anung-git/skripsi/SOFTWARE/Android/gambar/motor_pump.jpg

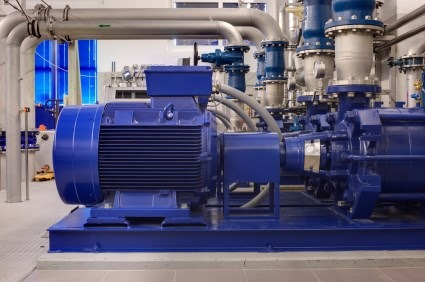
SOFTWARE/Android/gambar/motor_pump.jpg
