anung-git/skripsi/PPT/Skripsi Anung.pptx

Kendali Pompa Air Berbasis IoT

Oleh:
Anung
312118052

## Slide 2

Latar
Belakang

Easy to change colors.

Get a modern PowerPoint Presentation that is beautifully designed. Easy to change colors, photos and Text. You can simply impress your audience and add a unique zing and appeal to your Presentations. Get a modern PowerPoint Presentation that is beautifully designed. Easy to change colors, photos and Text.
You can simply impress your audience and add a unique zing and appeal to your Presentations. You can simply impress your audience and add a unique zing and appeal to your Presentations. Get a modern PowerPoint Presentation that is beautifully designed. Easy to change colors, photos and Text. You can simply impress your audience and add a unique zing and appeal to your Presentations. Get a modern PowerPoint Presentation that is beautifully designed. Easy to change colors, photos and Text.
You can simply impress your audience and add a unique zing and appeal to your Presentations.

## Slide 3

Section Break

Insert the Sub Title of Your Presentation

## Slide 4

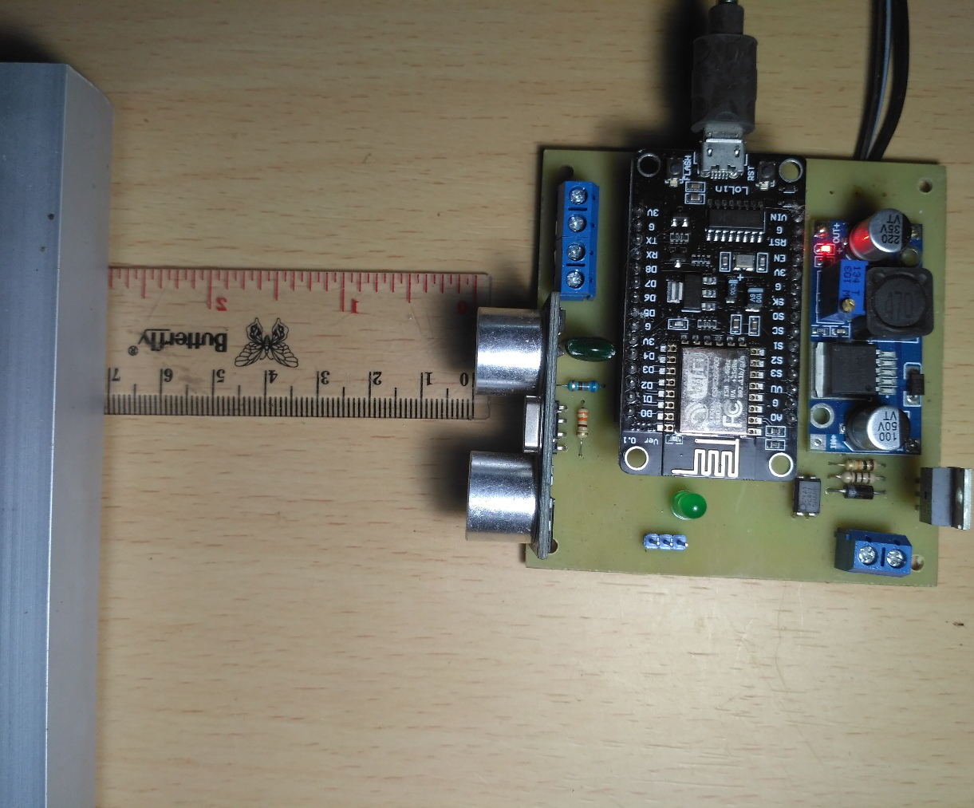
[picture p2: figure]

Pengujian
Sensor PING

Easy to change colors, photos and Text.

Get a modern PowerPoint Presentation that is beautifully designed. Easy to change colors, photos and Text. You can simply impress your audience and add a unique zing and appeal to your Presentations. Get a modern PowerPoint Presentation that is beautifully designed. Easy to change colors, photos and Text. Get a modern PowerPoint Presentation that is beautifully designed. You can simply impress your audience and add a unique zing and appeal to your Presentations.

Get a modern PowerPoint Presentation that is beautifully designed.

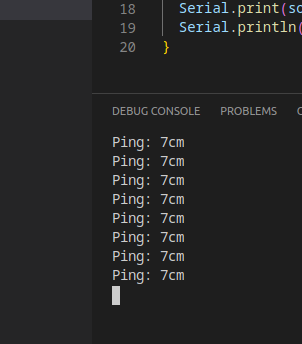
[picture p3: figure]

You can simply impress your audience and add a unique zing and appeal.

## Slide 5

Agenda Style

Contents Title

You can simply impress your audience and add a unique zing and appeal to your Presentations. Easy to change colors, photos and Text.

Contents Title

You can simply impress your audience and add a unique zing and appeal to your Presentations. Easy to change colors, photos and Text.

Contents Title

You can simply impress your audience and add a unique zing and appeal to your Presentations. Easy to change colors, photos and Text.

Contents Title

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

01

02

03

04

## Slide 6

AWESOME

PRESENTATION

EASY TO CHANGE COLORS, PHOTOS.

You can simply impress your audience and add a unique zing and appeal to your Presentations. Get a modern PowerPoint Presentation that is beautifully designed. I hope and I believe that this Template will your Time, Money and Reputation.

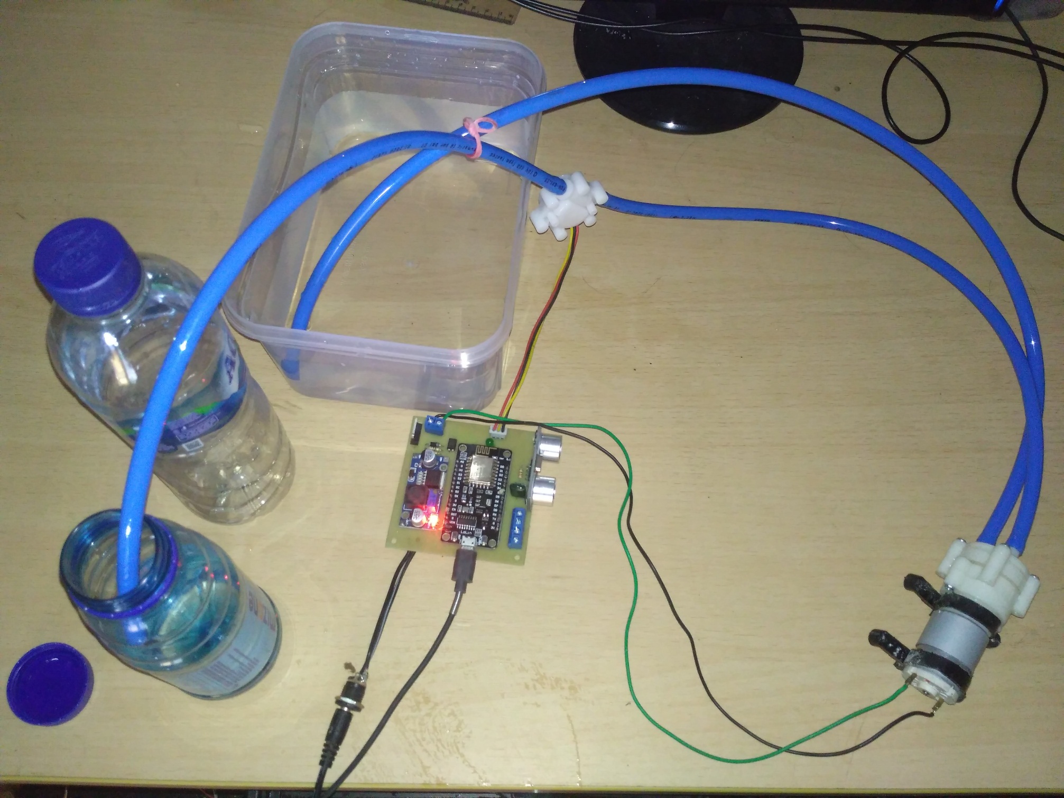
[picture p4: figure]

Get a modern PowerPoint Presentation that is beautifully designed.

I hope and I believe that this Template will your Time, Money and Reputation. Easy to change colors, photos and Text. You can simply impress your audience and add a unique zing and appeal to your Presentations

MODERN

PowerPoint

DESIGN

## Slide 7

AWESOME

PRESENTATION

EASY TO CHANGE COLORS, PHOTOS.

You can simply impress your audience and add a unique zing and appeal to your Presentations. Get a modern PowerPoint Presentation that is beautifully designed. I hope and I believe that this Template will your Time, Money and Reputation.

Get a modern PowerPoint Presentation that is beautifully designed.

I hope and I believe that this Template will your Time, Money and Reputation. Easy to change colors, photos and Text. You can simply impress your audience and add a unique zing and appeal to your Presentations

MODERN

PowerPoint

DESIGN

## Slide 8

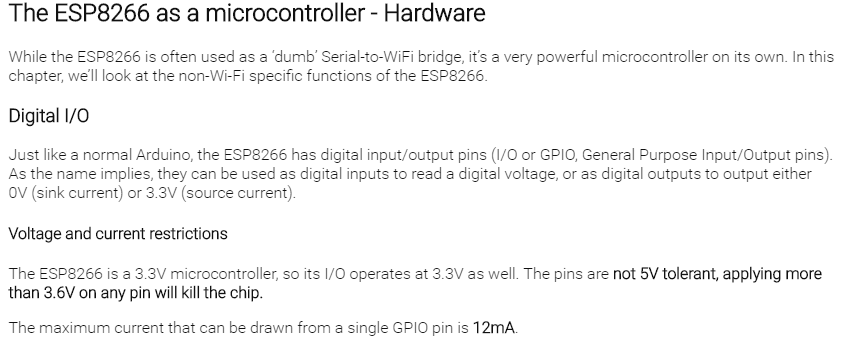
[picture p5: figure]

## Slide 9

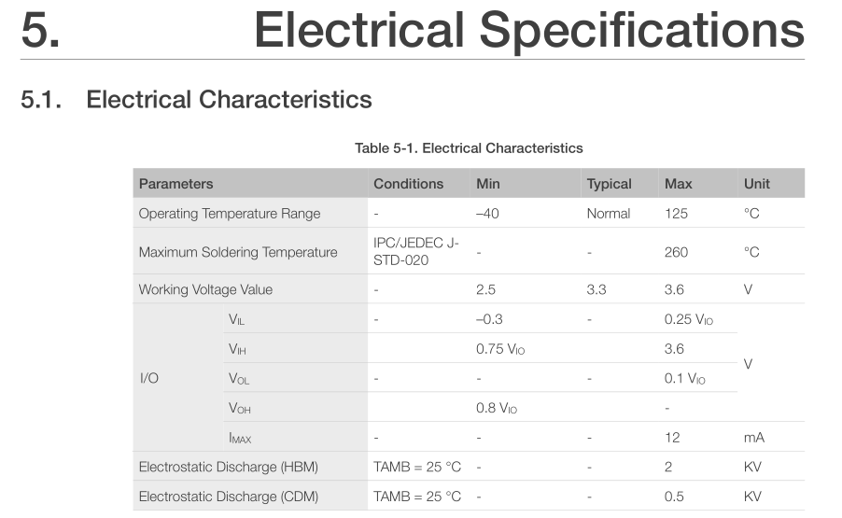
[picture p6: figure]

## Slide 10

- Timeline Infographic

2013

2014

2015

2016

2017

2018

2019

Content Here

Get a modern PowerPoint Presentation that is beautifully designed

Content Here

Get a modern PowerPoint Presentation that is beautifully designed

Content Here

Get a modern PowerPoint Presentation that is beautifully designed

Content Here

Get a modern PowerPoint Presentation that is beautifully designed

Content Here

Get a modern PowerPoint Presentation that is beautifully designed

Content Here

Get a modern PowerPoint Presentation that is beautifully designed

Content Here

Get a modern PowerPoint Presentation that is beautifully designed

## Slide 11

- Our Team Infographic

We Create
Professional Presentation

Get a modern PowerPoint Presentation that is beautifully designed. I hope and I believe that this Template will your Time, Money and Reputation. Easy to change colors, photos and Text. Get a modern PowerPoint Presentation that is beautifully designed. You can simply impress your audience and add a unique zing and appeal to your Presentations.

Work Experience

2013 ~ 2014 Text here
Example Text : Get a modern PowerPoint Presentation that is beautifully designed.

2014 ~ 2016Text here
Example Text : Get a modern PowerPoint Presentation that is beautifully designed

2016 ~ 2019 Text here
Example Text : Get a modern PowerPoint Presentation that is beautifully designed.

Progress Company

Presentation

Presentation

Presentation

Presentation

MICHAEL DOE

## Slide 12

- Infographic Style

Modern PowerPoint Presentation

NO.1 Presentation

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

Contents Title

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

Contents Title

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

Contents Title

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

## Slide 13

- Infographic Style

Your Text Here

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

STRENGTHS

OPPORTUNITIES

WEAKNESS

THREATS

S

W

Your Text Here

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

Your Text Here

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

O

T

Your Text Here

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

## Slide 14

AWESOME
SLIDE

LOREM IPSUM DOLOR SIT AMET,
CU USU AGAM INTEGRE IMPEDIT.

Your Text Here

Your Text Here

Your Text Here

Easy to change colors, photos and Text.

$ 64,090

LOREM IPSUM DOLOR SIT AMET,
CU USU AGAM INTEGRE IMPEDIT.

Easy to change colors, photos and Text.

$124,090

LOREM IPSUM DOLOR SIT AMET,
CU USU AGAM INTEGRE IMPEDIT.

Easy to change colors, photos and Text.

$234,090

## Slide 15

- MQTT Basic

INSERT CONTENTS

INSERT CONTENTS

Publish

MQTT
Broker

Subscibe

INSERT CONTENTS

INSERT CONTENTS

You can simply impress your audience and add a unique zing and appeal to your Reports and Presentations with our Templates. Get a modern PowerPoint Presentation that is beautifully designed.

## Slide 16

- Infographic Style

Your Text Here

You can simply impress your audience and add a unique zing and appeal to your Presentations.

Your Text Here

You can simply impress your audience and add a unique zing and appeal to your Presentations.

Your Text Here

You can simply impress your audience and add a unique zing and appeal to your Presentations.

## Slide 17

Industrial Automation Solutions

POWERPOINT

You can simply impress your audience and add a unique zing and appeal to your Presentations

CONTENTS

You can simply impress your audience and add a unique zing and appeal to your Presentations.

You can simply impress your audience and add a unique zing and appeal to your Presentations.

TEXT

## Slide 18

- Infographic Style

Industrial automation

Your Text Here

You can simply impress your audience and add a unique zing and appeal to your Presentations.

Your Text Here

You can simply impress your audience and add a unique zing and appeal to your Presentations.

Your Text Here

You can simply impress your audience and add a unique zing and appeal to your Presentations.

Your Text Here

You can simply impress your audience and add a unique zing and appeal to your Presentations.

Your Text Here

You can simply impress your audience and add a unique zing and appeal to your Presentations.

Your Text Here

You can simply impress your audience and add a unique zing and appeal to your Presentations.

## Slide 19

- Infographic Style

1st

Your Text Here

I hope and I believe that this Template will your Time, Money and Reputation. Get a modern PowerPoint Presentation that is beautifully designed.

3st

Your Text Here

I hope and I believe that this Template will your Time, Money and Reputation. Get a modern PowerPoint Presentation that is beautifully designed.

2st

Your Text Here

I hope and I believe that this Template will your Time, Money and Reputation. Get a modern PowerPoint Presentation that is beautifully designed.

4st

Your Text Here

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

## Slide 20

- Infographic Style

Your Text Here

You can simply impress your audience and add a unique zing and appeal to your Presentations.

Your Text Here

You can simply impress your audience and add a unique zing and appeal to your Presentations.

Text Here

Your Text Here

You can simply impress your audience and add a unique zing and appeal to your Presentations.

Your Text Here

You can simply impress your audience and add a unique zing and appeal to your Presentations.

## Slide 21

- Infographic Style

Contents Title

You can simply impress your audience and add a unique zing and appeal to your Presentations.

Contents Title

You can simply impress your audience and add a unique zing and appeal to your Presentations.

Contents Title

You can simply impress your audience and add a unique zing and appeal to your Presentations.

## Slide 22

Portfolio Designed

You can simply impress your audience and add a unique zing and appeal to your Presentations. I hope and I believe that this Template will your Time, Money and Reputation. Get a modern PowerPoint Presentation that is beautifully designed. You can simply impress your audience and add a unique zing and appeal to your Presentations.
Get a modern PowerPoint Presentation that is beautifully designed.

Content Here

Get a modern PowerPoint Presentation that is beautifully designed. Easy to change colors, photos and Text.

Content Here

Get a modern PowerPoint Presentation that is beautifully designed. Easy to change colors, photos and Text.

Portfolio Presentation

INDUSTRY

Content Here

Get a modern PowerPoint Presentation that is beautifully designed. Easy to change colors, photos and Text.

Content Here

Get a modern PowerPoint Presentation that is beautifully designed. Easy to change colors, photos and Text.

## Slide 23

Simple PowerPoint Presentation

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

Contents _ Graph

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

Contents

Contents

Contents

Contents _ Graph

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

Contents _ Graph

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

## Slide 24

- Infographic Style

02

03

01

04

03

01

Content Here

You can simply impress your audience and add a unique zing and appeal to your Presentations.

80%

60%

02

50%

Content Here

You can simply impress your audience and add a unique zing and appeal to your Presentations.

40%

Content Here

You can simply impress your audience and add a unique zing and appeal to your Presentations.

04

Content Here

You can simply impress your audience and add a unique zing and appeal to your Presentations.

## Slide 25

ALLPPT Layout
Clean Text Slide for your Presentation

Get a modern PowerPoint Presentation that is beautifully designed. Easy to change colors, photos and Text. You can simply impress your audience and add a unique zing and appeal to your Presentations. Get a modern PowerPoint Presentation that is beautifully designed. Easy to change colors, photos and Text.
Easy to change colors, photos and Text. You can simply impress your audience and add a unique zing and appeal to your Presentations.

Add Contents Title

## Slide 26

- Infographic Style

Content Here

Get a modern PowerPoint Presentation that is beautifully designed. hope and I believe that this Template will your Time.

Content Here

Get a modern PowerPoint Presentation that is beautifully designed. hope and I believe that this Template will your Time.

Content Here

Get a modern PowerPoint Presentation that is beautifully designed. hope and I believe that this Template will your Time.

Content Here

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

## Slide 27

- Infographic Style

TITLE | A TITLE | | | B TITLE | | | C TITLE
Replaced with your own text. | Text Here | | | Text | | | Content Here
PowerPiont Template | Content Here | | | Content Here | | | Text
Replaced with your own text. | Text Here | | | Text | | | Content Here
PowerPiont Template | Content Here | | | Content Here | | | Text
Replaced with your own text. | Text Here | | | Text | | | Content Here
PowerPiont Template | Content Here | | | Content Here | | | Text
Replaced with your own text. | Text Here | | | Text | | | Content Here
PowerPiont Template | Content Here | | | Content Here | | | Text
Content Here | Text Here | | | Text | | | Content Here
| | Content Here | | | Content Here | | | Content Here

## Slide 28

Awesome Presentation

We Create Professional Presentation

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

## Slide 29

- Infographic Style

Add Contents Title

You can simply impress your audience and add a unique zing and appeal to your Presentations.

Add Contents Title

You can simply impress your audience and add a unique zing and appeal to your Presentations.

Add Contents Title

You can simply impress your audience and add a unique zing and appeal to your Presentations.

Add Contents Title

You can simply impress your audience and add a unique zing and appeal to your Presentations.

Add Contents Title

You can simply impress your audience and add a unique zing and appeal to your Presentations.

## Slide 30

- Infographic Style

| You can simply impress your audience and add a unique zing
| Add Text

| You can simply impress your audience and add a unique zing
| Add Text

Your Text Here

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

| You can simply impress your audience and add a unique zing
| Add Text

Your Text Here

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

| You can simply impress your audience and add a unique zing
| Add Text

Add Text

Easy to change colors, photos and Text.

## Slide 31

Get a modern PowerPoint Presentation that is beautifully designed.

Get a modern PowerPoint Presentation that is beautifully designed.

Get a modern PowerPoint Presentation that is beautifully designed.

Get a modern PowerPoint Presentation that is beautifully designed.

Get a modern PowerPoint Presentation that is beautifully designed.

Get a modern PowerPoint Presentation that is beautifully designed.

Get a modern PowerPoint Presentation that is beautifully designed.

## Slide 32

- Infographic Style

CLOUD COMPUTING

Content Here

Get a modern PowerPoint Presentation that is beautifully designed.

Content Here

Get a modern PowerPoint Presentation that is beautifully designed.

Content Here

Get a modern PowerPoint Presentation that is beautifully designed.

## Slide 33

- Infographic Style

Your Text Here | | | Your Text Here | | | Your Text Here | | | Your Text Here
| Text Here | | | Text Here | | | Text Here | | | Text Here
| Text Here | | | Text Here | | | Text Here | | | Text Here
| Text Here | | | Text Here | | | Text Here | | | Text Here
| Text Here | | | Text Here | | | Text Here | | | Text Here
| Text Here | | | Text Here | | | Text Here | | | Text Here
| Text Here | | | Text Here | | | Text Here | | | Text Here
| $ 1200 | | | $1000 | | | $600 | | | $500

## Slide 34

- Infographic Style

Get a modern PowerPoint Presentation that is beautifully designed.

Get a modern PowerPoint Presentation that is beautifully designed.

Get a modern PowerPoint Presentation that is beautifully designed.

Get a modern PowerPoint Presentation that is beautifully designed.

Content Here

Content Here

Content Here

Content Here

## Slide 35

- Infographic Style

Add Text

Easy to change colors, photos and Text.

Add Contents

Add Text

Easy to change colors, photos and Text.

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

Add Text

Easy to change colors, photos and Text.

Add Contents

Add Text

Easy to change colors, photos and Text.

Add Contents

Add Contents

## Slide 36

- Infographic Style

01

02

03

04

Content Here

Get a modern PowerPoint Presentation that is beautifully designed. I hope and I believe that this Template will your Time.
You can simply impress your audience and add a unique zing and appeal to your Reports.

Content Here

Get a modern PowerPoint Presentation that is beautifully designed. I hope and I believe that this Template will your Time.
You can simply impress your audience and add a unique zing and appeal to your Reports.

Content Here

Get a modern PowerPoint Presentation that is beautifully designed. I hope and I believe that this Template will your Time.
You can simply impress your audience and add a unique zing and appeal to your Reports.

Content Here

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

## Slide 37

Get a modern PowerPoint

You can simply impress your audience and add a unique zing and appeal to your Presentations. Easy to change colors, photos and Text. Get a modern PowerPoint Presentation that is beautifully designed. You can simply impress your audience and add a unique zing and appeal to your Presentations.

Simple Portfolio Presentation

Content Here : I hope and I believe that this Template will your Time.

Content Here : I hope and I believe that this Template will your Time.

Content Here : I hope and I believe that this Template will your Time.

Content Here : I hope and I believe that this Template will your Time.

Content Here : I hope and I believe that this Template will your Time.

## Slide 38

- Infographic Style

65%

75%

$23,900

Contents Here

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

$23,900

Contents Here

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

## Slide 39

- Infographic Style

Content Here

Get a modern PowerPoint Presentation that is beautifully designed.

Content Here

Get a modern PowerPoint Presentation that is beautifully designed.

Content Here

Get a modern PowerPoint Presentation that is beautifully designed.

Content Here

Get a modern PowerPoint Presentation that is beautifully designed.

Content Here

Get a modern PowerPoint Presentation that is beautifully designed.

Content Here

Get a modern PowerPoint Presentation that is beautifully designed.

Content Here

Get a modern PowerPoint Presentation that is beautifully designed.

## Slide 40

Simple
Portfolio Presentation

Easy to change colors, photos and Text.

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

Get a modern PowerPoint Presentation that is beautifully designed.

You can simply impress your audience and add a unique zing and appeal.

## Slide 41

- Infographic Style

Country

Data_01 : 12,000
Data_02 : 23,300

Country

Data_01 : 12,000
Data_02 : 23,300

Country

Data_01 : 12,000
Data_02 : 23,300

Country

Data_01 : 12,000
Data_02 : 23,300

Contents
Performance

Easy to change colors, photos and Text.

Contents
Performance

Easy to change colors, photos and Text.

Contents
Performance

Easy to change colors, photos and Text.

Contents
Performance

Easy to change colors, photos and Text.

## Slide 42

- Infographic Style

Text Here Modern PowerPoint
$25
Contents | | Text
| Text Here
| Content Here
| Text Here
| Text Here
| Easy to change colors, photos and Text.

Text Here Modern PowerPoint
$100
Contents | | Text
| Text Here
| Content Here
| Text Here
| Text Here
| Easy to change colors, photos and Text.

Text Here Modern PowerPoint
$65
Contents | | Text
| Text Here
| Content Here
| Text Here
| Text Here
| Easy to change colors, photos and Text.

Text Here Modern PowerPoint
$20
Contents | | Text
| Text Here
| Content Here
| Text Here
| Text Here
| Easy to change colors, photos and Text.

## Slide 43

Portfolio Designed

You can simply impress your audience and add a unique zing and appeal to your Presentations. I hope and I believe that this Template will your Time, Money and Reputation. Get a modern PowerPoint Presentation that is beautifully designed.
Get a modern PowerPoint Presentation that is beautifully designed.

Content

Content

Content

Content

Content Here

Get a modern PowerPoint Presentation that is beautifully designed. Easy to change colors, photos and Text.

Content Here

Get a modern PowerPoint Presentation that is beautifully designed. Easy to change colors, photos and Text.

Simple Portfolio
Presentation

Content Here

Get a modern PowerPoint Presentation that is beautifully designed. Easy to change colors, photos and Text.

Content Here

Get a modern PowerPoint Presentation that is beautifully designed. Easy to change colors, photos and Text.

## Slide 44

- Infographic Style

50%

40%

Your Text Here

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

Your Text Here

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

Content

70%

Your Text Here

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

## Slide 45

- Infographic Style

83%

Your Text Here

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

Your Text Here

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

65%

43%

Your Text Here

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

75%

Your Text Here

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

## Slide 46

Columns Infographic Style

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

## Slide 47

TerimaKasih

## Slide 48

- Fully Editable Shapes

## Slide 49

- Fully Editable Shapes

## Slide 50

- Fully Editable Icon Sets: A

## Slide 51

- Fully Editable Icon Sets: B

## Slide 52

- Fully Editable Icon Sets: C

## Slide 53

- Hall Effect

## Slide 54

## Slide 55

- Hall Efek

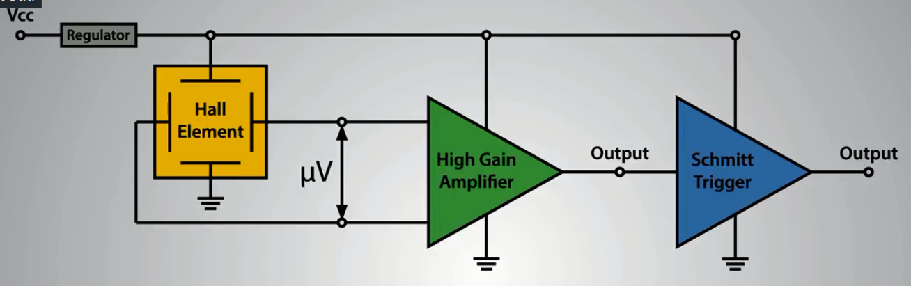
[picture p7: figure]

## Slide 56

- Hall effect

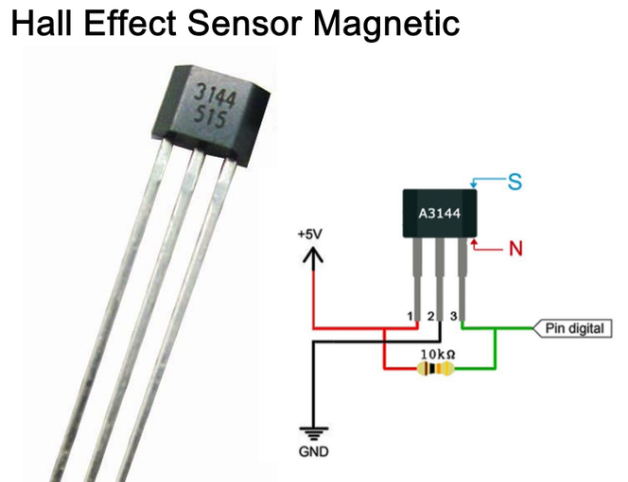
[picture p8: figure]

## Slide 57
