anung-git/skripsi/LAPORAN/flowchart/flow sumur lengkap (6).png

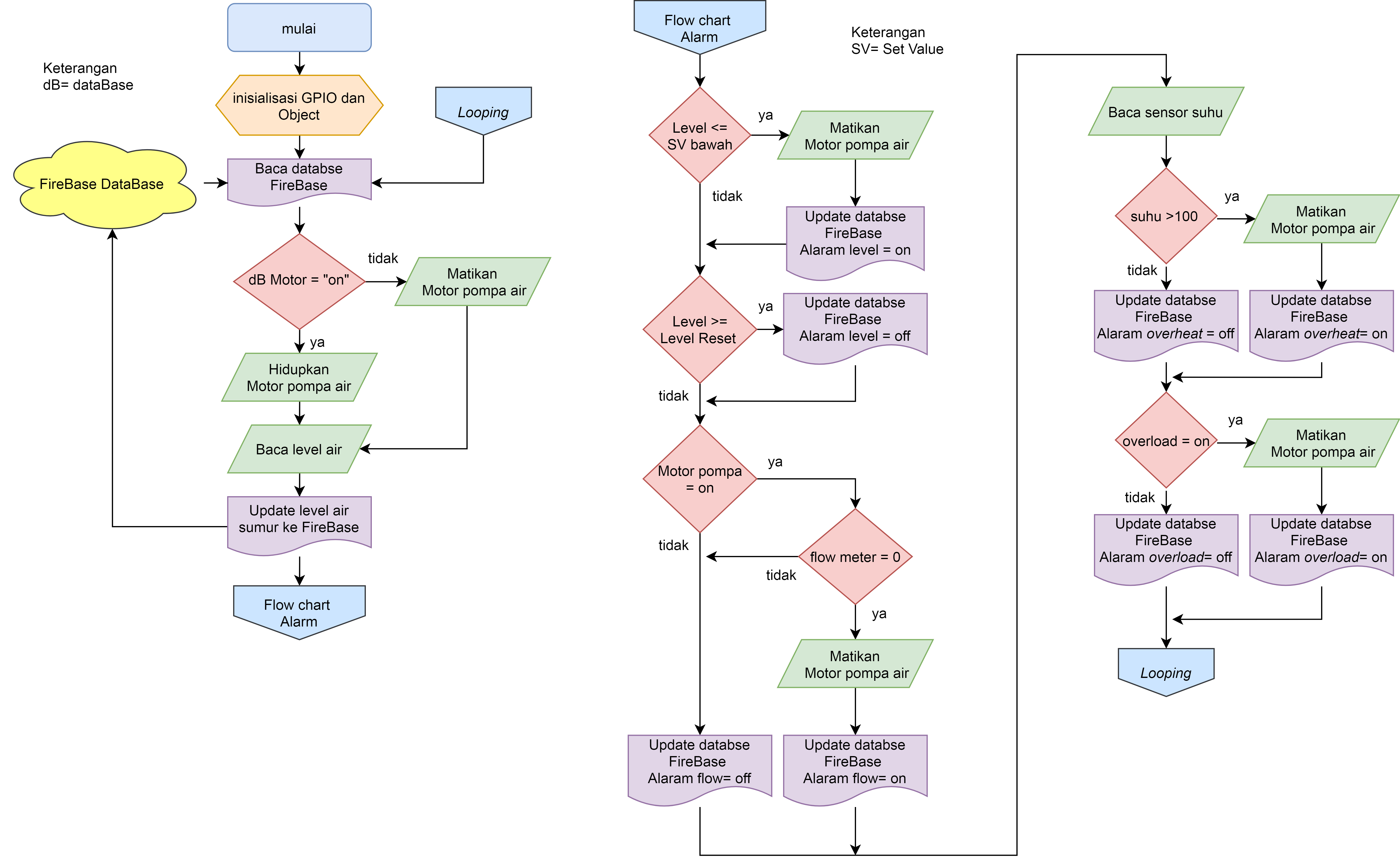
LAPORAN/flowchart/flow sumur lengkap (6).png
