anung-git/skripsi/LAPORAN/flowchart/flow tangki.png

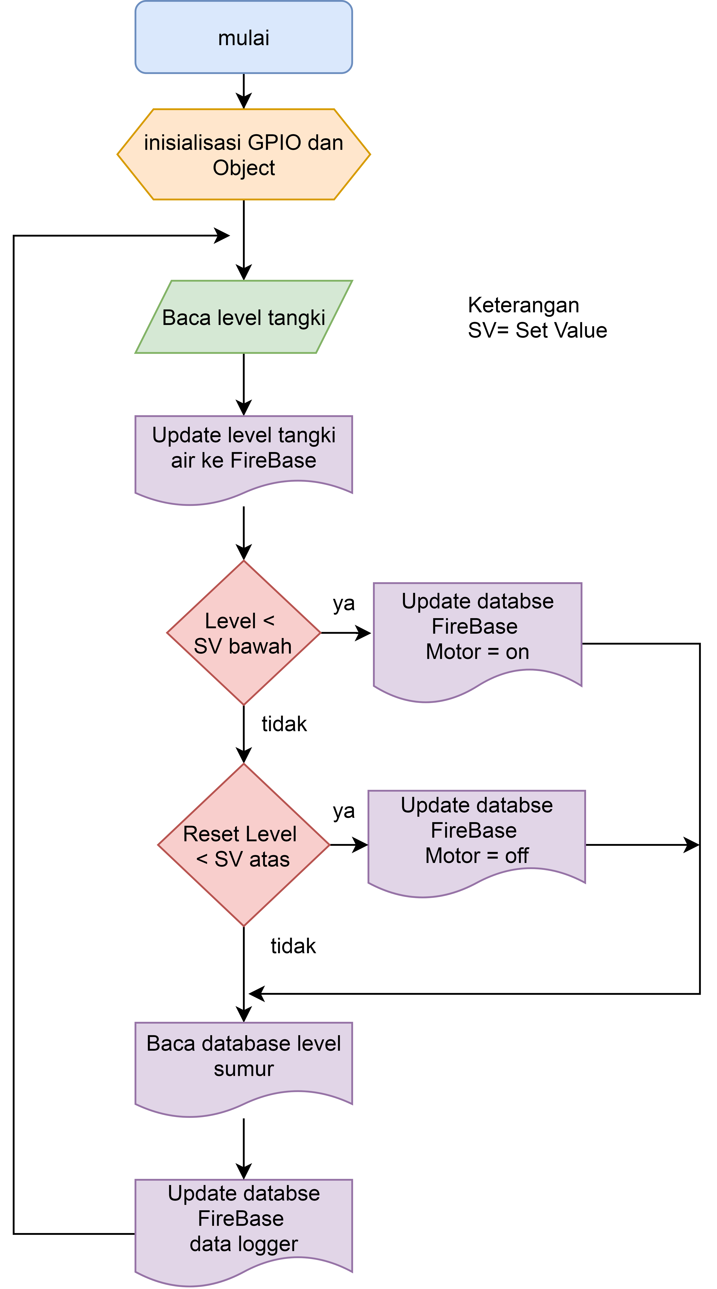
LAPORAN/flowchart/flow tangki.png
