anung-git/skripsi/LAPORAN/skematik/pdf/driver_motor.pdf

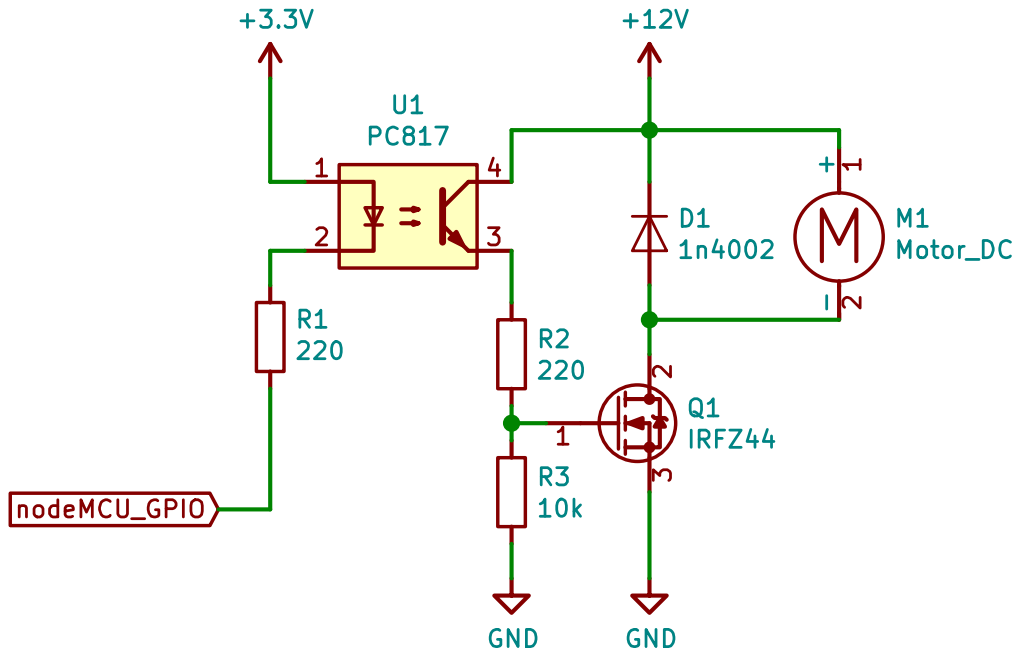
[picture p61: page 1]

File: driver_motor.sch Sheet: / Anung

Id: 1/1 Title: Driver Motor DC
