anung-git/skripsi/LAPORAN/skematik/pdf/sensor_flow.pdf

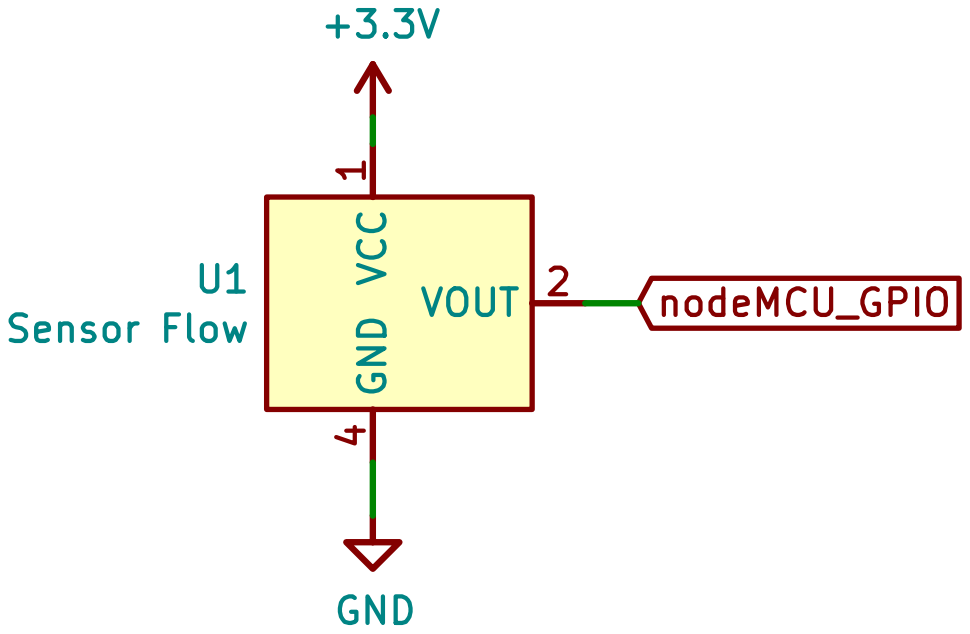
[picture p62: page 1]

1 VOUT 2 GND
File: sensor_flow.sch Sheet: / VCC
