anung-git/skripsi/LAPORAN/skematik/pdf/sensor_suhu.pdf

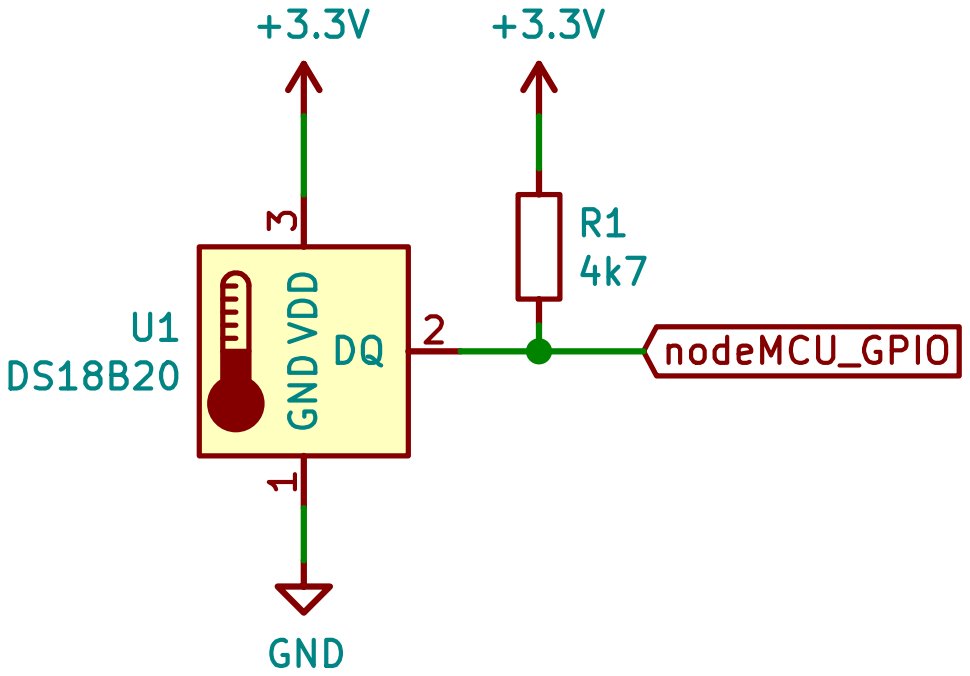
[picture p63: page 1]

1 DQ VDD
File: sensor_ping.sch Sheet: / GND
