anung-git/skripsi/LAPORAN/LAMPIRAN/tangki.pdf

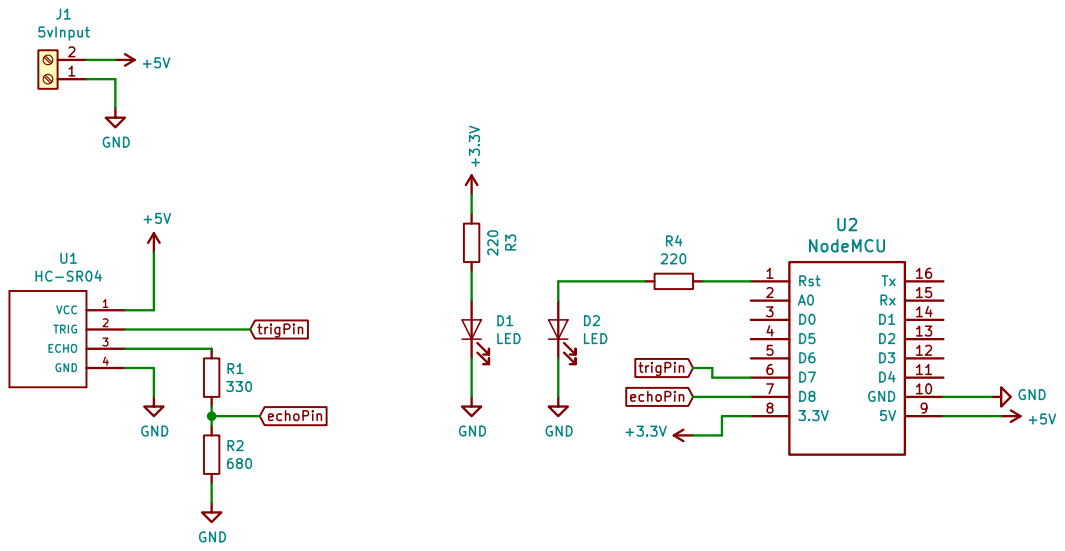
[picture p64: page 1]

File: tangki.sch Sheet: / ANUNG

Id: 1/1 Title: SKRIPSI POMPA AIR IOT
