anung-git/skripsi/LAPORAN/LAMPIRAN/sumur.pdf

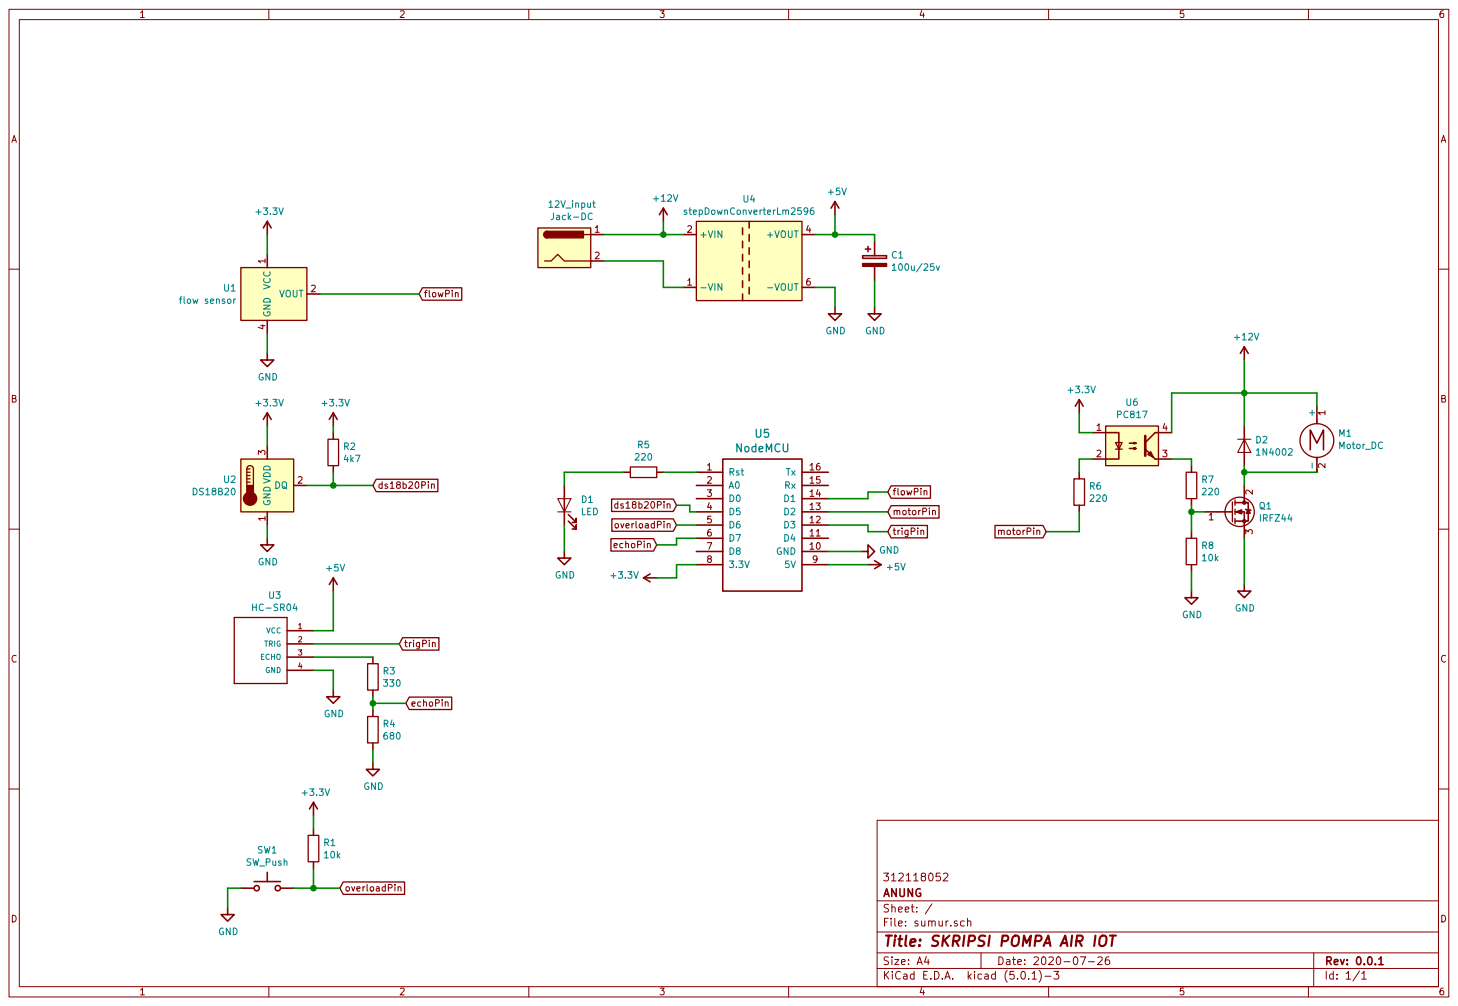
[picture p65: page 1]

File: sumur.sch Sheet: / ANUNG

Id: 1/1 Title: SKRIPSI POMPA AIR IOT
