anung-git/skripsi/LAPORAN/skematik/pdf/pembagi tegangan.pdf

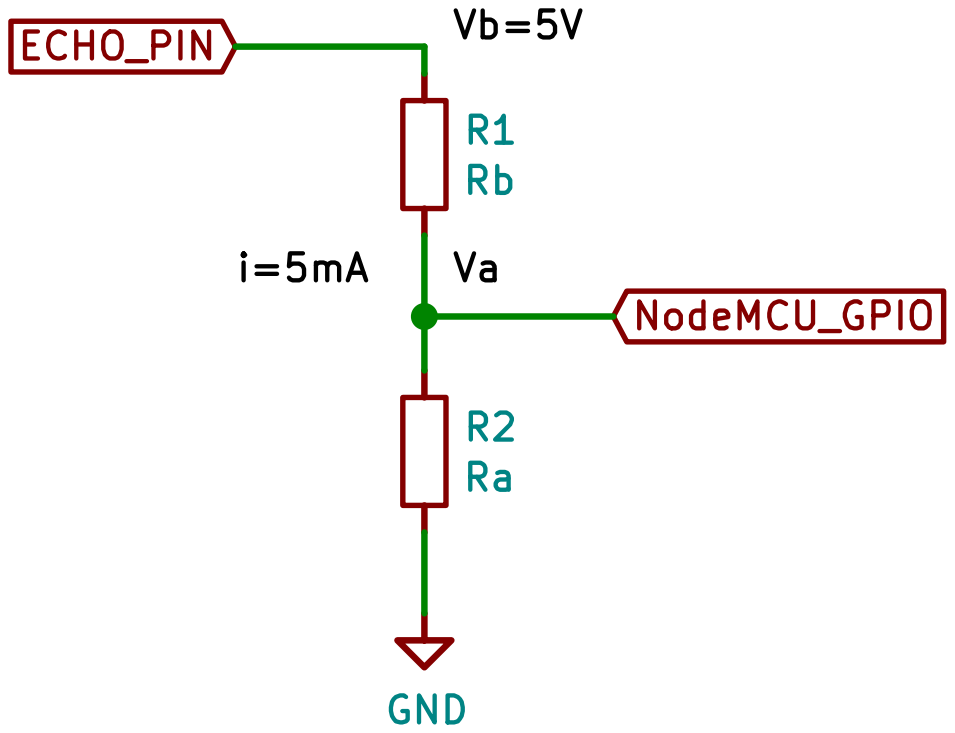
[picture p66: page 1]

File: pembagi tegangan.sch Sheet: /
Id: 1/1 Title:
