anung-git/skripsi/pcb/skripsi/skripsi.kicad_pcb

## KiCad design pcb/skripsi/skripsi.kicad_pcb (2020-08-06)

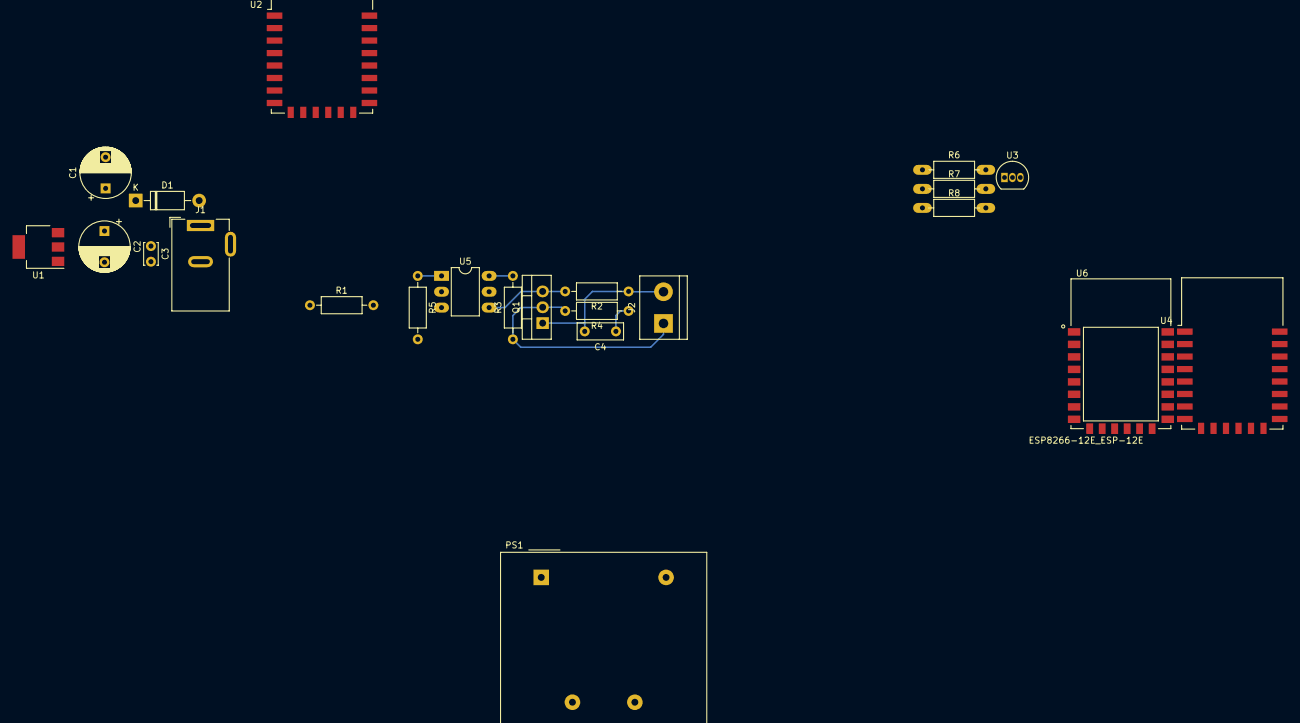
[picture p67: board skripsi.kicad_pcb from above]

Board: 2 copper layers, 23 parts (0 on the bottom side), 14 nets.

Parts:
C1: 470uF/16v; CP_Radial_D8.0mm_P5.00mm
C2: 100uF/16v; CP_Radial_D8.0mm_P5.00mm
C3: 100nF; C_Disc_D3.4mm_W2.1mm_P2.50mm
C4: 10nF/1000v; C_Rect_L7.2mm_W2.5mm_P5.00mm_FKS2_FKP2_MKS2_MKP2
D1: 1n4002; D_DO-41_SOD81_P10.16mm_Horizontal
J1: Jack-DC; BarrelJack_Wuerth_6941xx301002
J2: motor; TerminalBlock_bornier-2_P5.08mm
PS1: HS-40003; Converter_ACDC_Hahn_HS-400xx_THT
Q1: BT136-500; TO-220-3_Vertical
R1, R7, R8: 10k; R_Axial_DIN0207_L6.3mm_D2.5mm_P10.16mm_Horizontal
R2: 330; R_Axial_DIN0207_L6.3mm_D2.5mm_P10.16mm_Horizontal
R3: 360; R_Axial_DIN0207_L6.3mm_D2.5mm_P10.16mm_Horizontal
R4: 39; R_Axial_DIN0207_L6.3mm_D2.5mm_P10.16mm_Horizontal
R5: 68; R_Axial_DIN0207_L6.3mm_D2.5mm_P10.16mm_Horizontal
R6: 4k7; R_Axial_DIN0207_L6.3mm_D2.5mm_P10.16mm_Horizontal
U1: AP1117-33; SOT-223-3_TabPin2
U2: ESP-12E
U3: DS18B20; TO-92_Inline
U4: ESP-12F; ESP-12E
U5: MOC3041M; DIP-6_W7.62mm_LongPads
U6: ESP8266-12E_ESP-12E; XCVR_ESP8266-12E%2fESP-12E

Connections:
+3V3: C2.1, C3.1, R1.1, R6.1, R7.1, U1.2, U2.8, U3.3
+5V: C1.1, D1.1, U1.3
GND: C1.2, C2.2, C3.2, J1.2, R8.2, U1.1, U2.15, U3.1, U5.2
unnamed: C4.1, R4.1
unnamed: C4.2, J2.2, Q1.1, R2.1
unnamed: D1.2, J1.1
unnamed: J2.1, Q1.2, R3.1, R4.2
unnamed: Q1.3, R2.2, U5.4
unnamed: R1.2, U2.1
unnamed: R3.2, U5.6
unnamed: R5.1, U5.1
unnamed: R7.2, U2.18
unnamed: R8.1, U2.16
temp: R6.2, U3.2
