anung-git/skripsi/pcb/KENDALI POMPA TANK.brd

## EAGLE design pcb/KENDALI POMPA TANK.brd (2020-08-06)

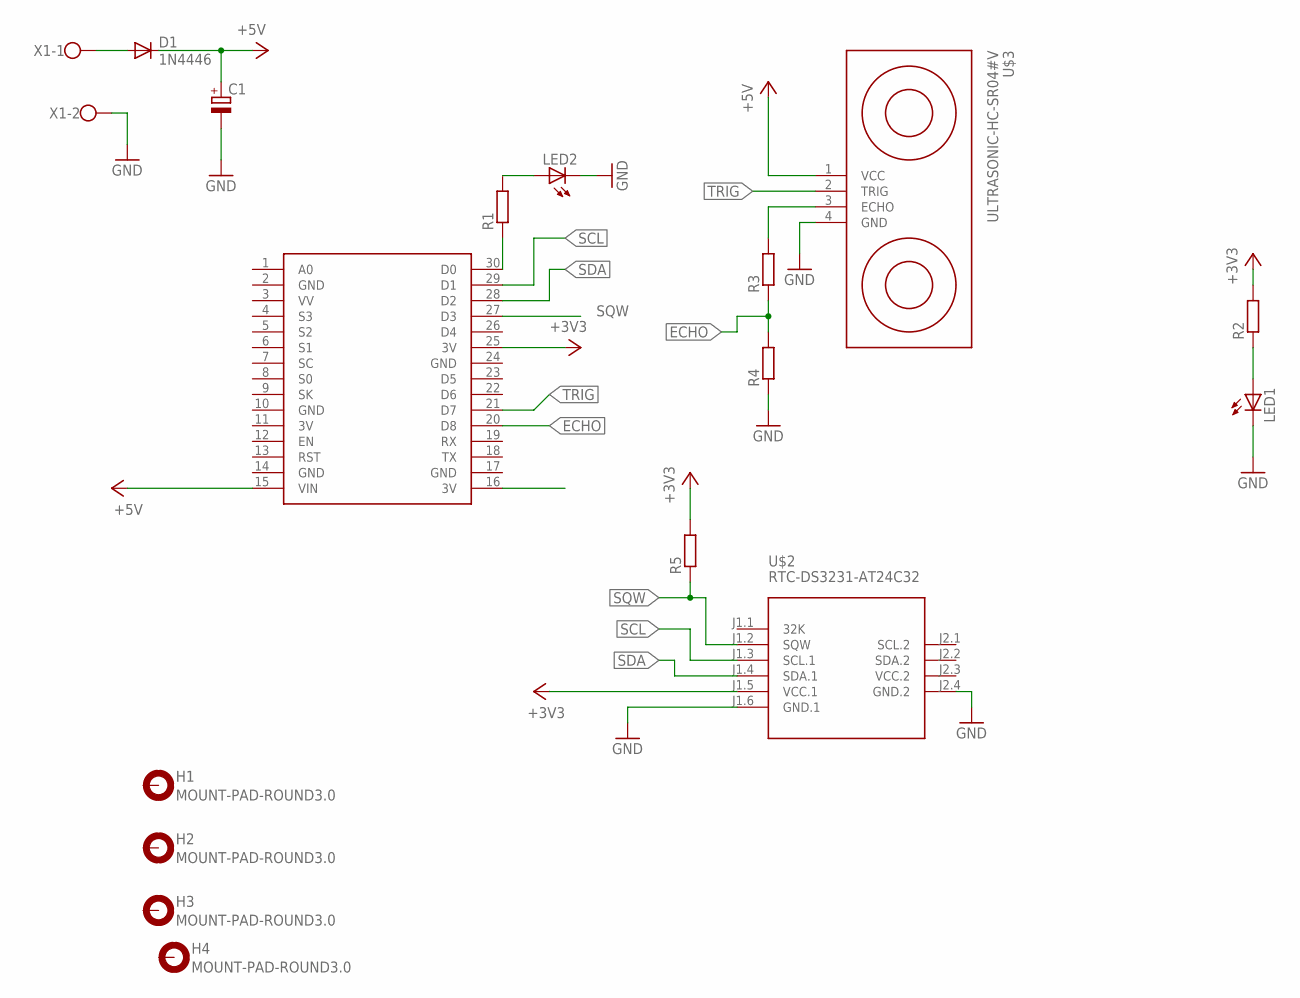
[picture p68: schematic KENDALI POMPA TANK.sch]

Parts:
C1: CPOL-EUE5-5; E5-5
D1: 1N4446; DO35-10
H1, H2, H3, H4: MOUNT-PAD-ROUND3.0; 3,0-PAD
LED1, LED2: LED5MM
R1, R2, R3, R4, R5: R-EU_0207/10; 0207/10
U$1: NODEMCU
U$2: RTC-DS3231-AT24C32
U$3: ULTRASONIC-HC-SR04#V
X1: W237-102

Connections:
3V: U$1.11 (3V)
+3V3: R2.2, R5.2, U$1.25 (3V), U$2.J1.5 (VCC.1)
+5V: C1.+, D1.C, U$1.15 (VIN), U$3.1 (VCC)
ECHO: R3.1, R4.2, U$1.20 (D8)
GND: C1.-, LED1.K (C), LED2.K (C), R4.1, U$1.2 (GND), U$1.10 (GND), U$1.14 (GND), U$1.17 (GND), U$1.24 (GND), U$2.J1.6 (GND.1), U$2.J2.4 (GND.2), U$3.4 (GND), X1.2
unnamed: R1.1, U$1.30 (D0)
unnamed: LED2.A, R1.2
unnamed: LED1.A, R2.1
unnamed: D1.A, X1.1
unnamed: R3.2, U$3.3 (ECHO)
SCL: U$1.29 (D1), U$2.J1.3 (SCL.1)
SDA: U$1.28 (D2), U$2.J1.4 (SDA.1)
SQW: R5.1, U$1.27 (D3), U$2.J1.2 (SQW)
TRIG: U$1.21 (D7), U$3.2 (TRIG)
VCC.2: U$2.J2.3 (VCC.2)

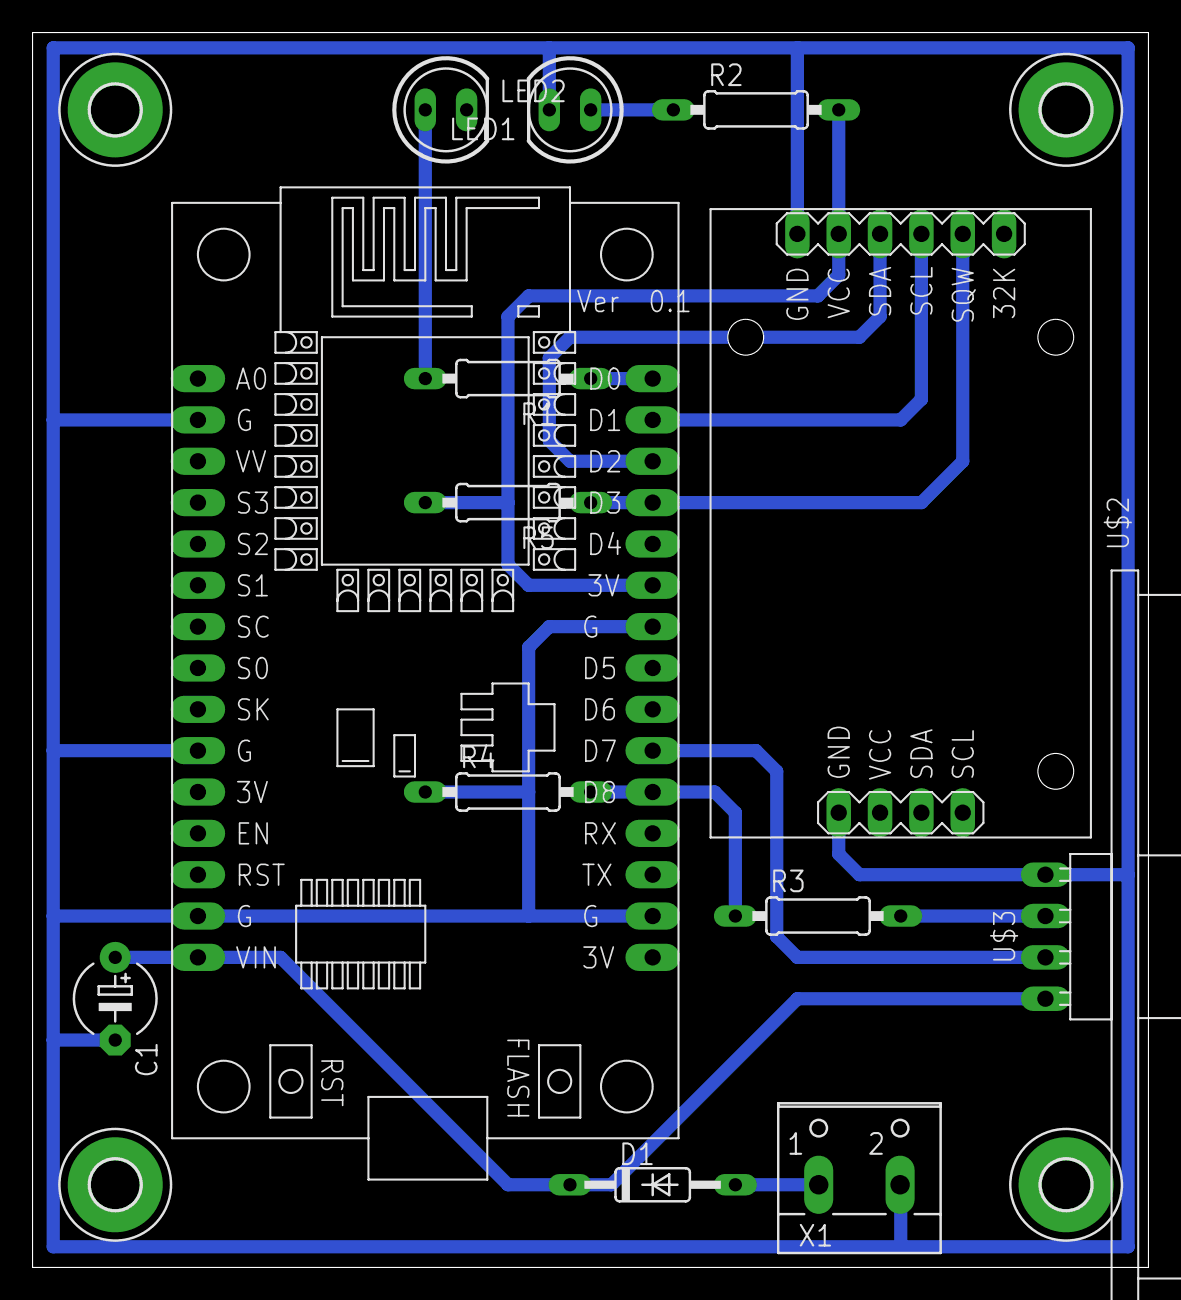
[picture p69: board KENDALI POMPA TANK.brd from above]

Board: 2 copper layers, 68.6 x 75.9 mm, 17 parts (0 on the bottom side), 13 nets.
