anung-git/skripsi/pcb/KENDALI POMPA AIR IOT.brd

## EAGLE design pcb/KENDALI POMPA AIR IOT.brd (2020-08-06)

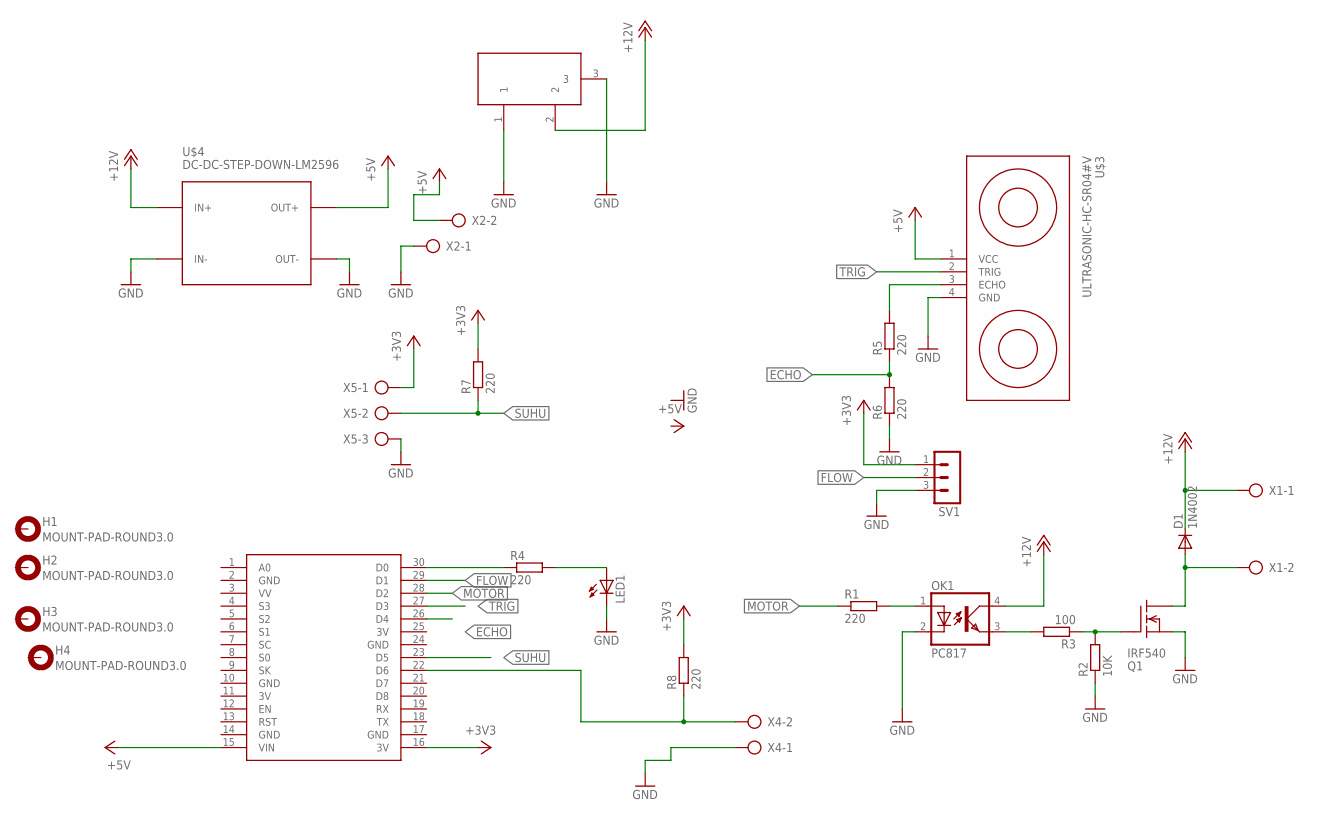
[picture p70: schematic KENDALI POMPA AIR IOT.sch]

Parts:
D1: 1N4002; DO35-10
H1, H2, H3, H4: MOUNT-PAD-ROUND3.0; 3,0-PAD
LED1: LED5MM
OK1: PC817; DIL04
Q1: IRF540; TO220
R1, R4, R5, R6, R7, R8: 220; 0207/10
R2: 10K; 0207/10
R3: 100; 0207/10
SV1: MA03-1
U$1: NODEMCU
U$2: DC21MMX; DC-21MM
U$3: ULTRASONIC-HC-SR04#V
U$4: DC-DC-STEP-DOWN-LM2596
X1, X2, X4: AK300/2
X5: AK300/3

Connections:
+3V3: R7.2, R8.2, SV1.1, U$1.11 (3V), U$1.16 (3V), U$1.25 (3V), X5.1
+5V: U$1.15 (VIN), U$3.1 (VCC), U$4.OUT+, X2.2
+12V: D1.C, OK1.4 (COL), U$2.2, U$4.IN+, X1.1
ECHO: R5.1, R6.2, U$1.26 (D4)
FLOW: SV1.2, U$1.29 (D1)
GND: LED1.K (C), OK1.2 (C), Q1.3 (S), R2.1, R6.1, SV1.3, U$1.2 (GND), U$1.10 (GND), U$1.14 (GND), U$1.17 (GND), U$1.24 (GND), U$2.1, U$2.3, U$3.4 (GND), U$4.IN-, U$4.OUT-, X2.1, X4.1, X5.3
MOTOR: R1.1, U$1.28 (D2)
unnamed: OK1.3 (EMIT), R3.2
unnamed: OK1.1 (A), R1.2
unnamed: Q1.1 (G), R2.2, R3.1
unnamed: D1.A, Q1.2 (D), X1.2
unnamed: LED1.A, R4.2
unnamed: R8.1, U$1.22 (D6), X4.2
unnamed: R4.1, U$1.30 (D0)
unnamed: R5.2, U$3.3 (ECHO)
SUHU: R7.1, U$1.23 (D5), X5.2
TRIG: U$1.27 (D3), U$3.2 (TRIG)

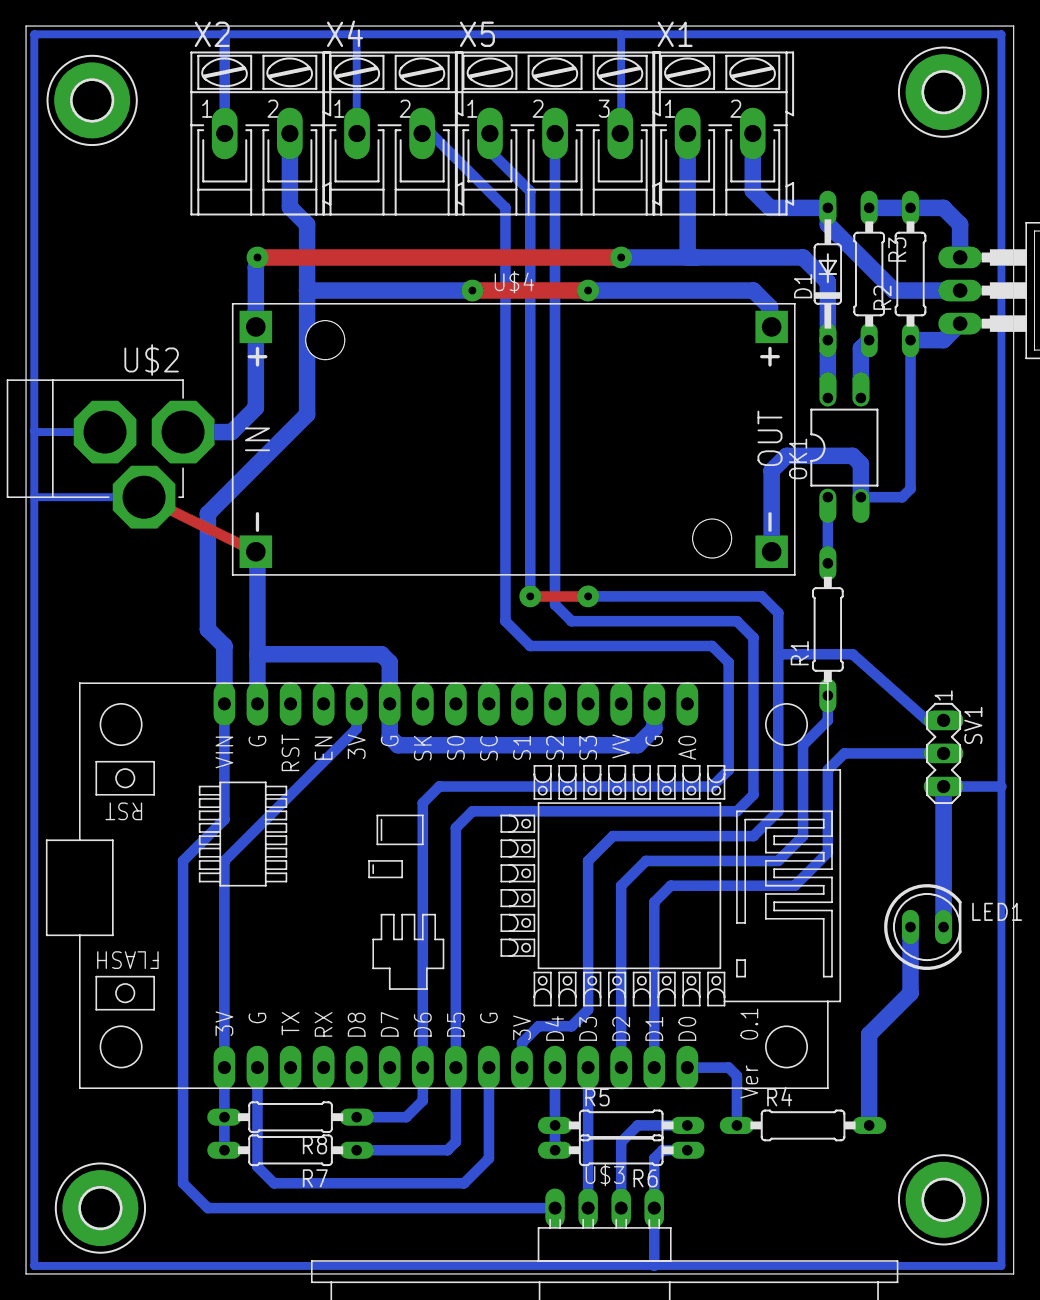
[picture p71: board KENDALI POMPA AIR IOT.brd from above]

Board: 2 copper layers, 75.9 x 95.9 mm, 25 parts (0 on the bottom side), 17 nets.
